herebefrogs/dataglove-as-numpad/images/1.Prototype for software.jpg

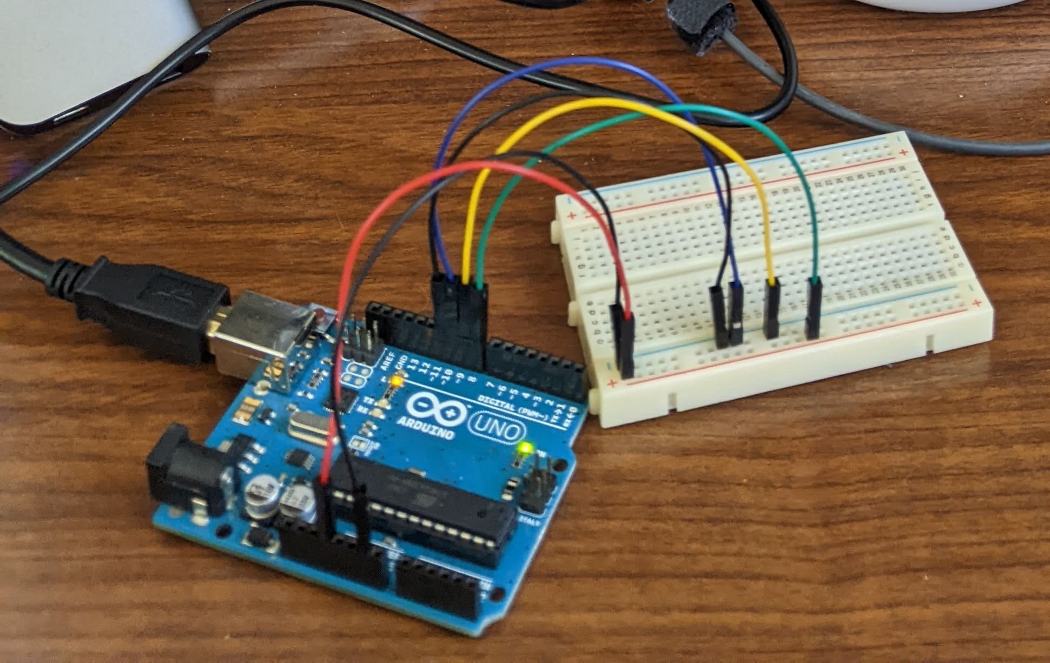
images/1.Prototype for software.jpg
