herebefrogs/dataglove-as-numpad/images/2.Software Command Line Interface.jpg

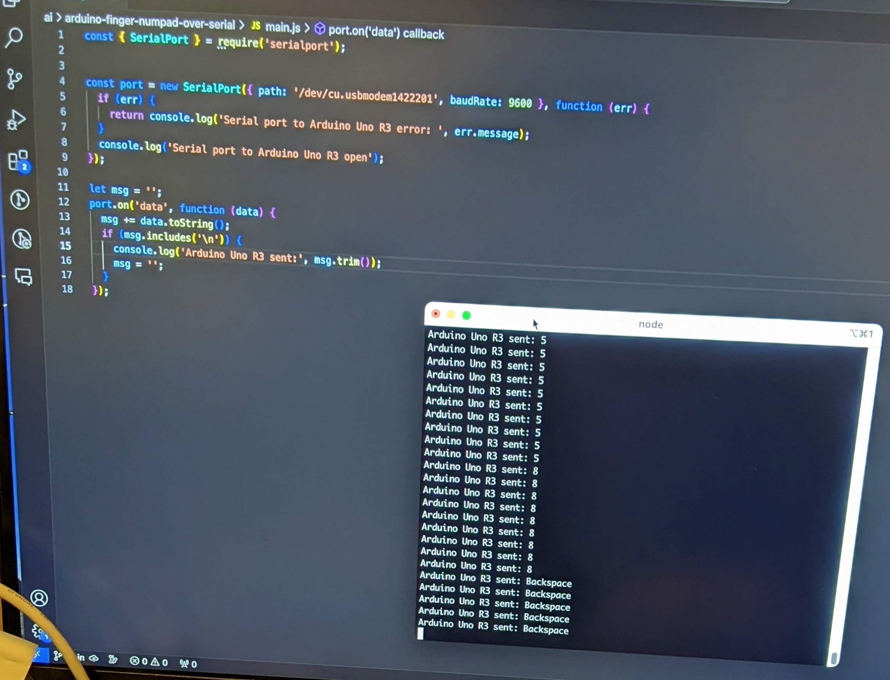
images/2.Software Command Line Interface.jpg
