herebefrogs/dataglove-as-numpad/images/3.Software Web Page.jpg

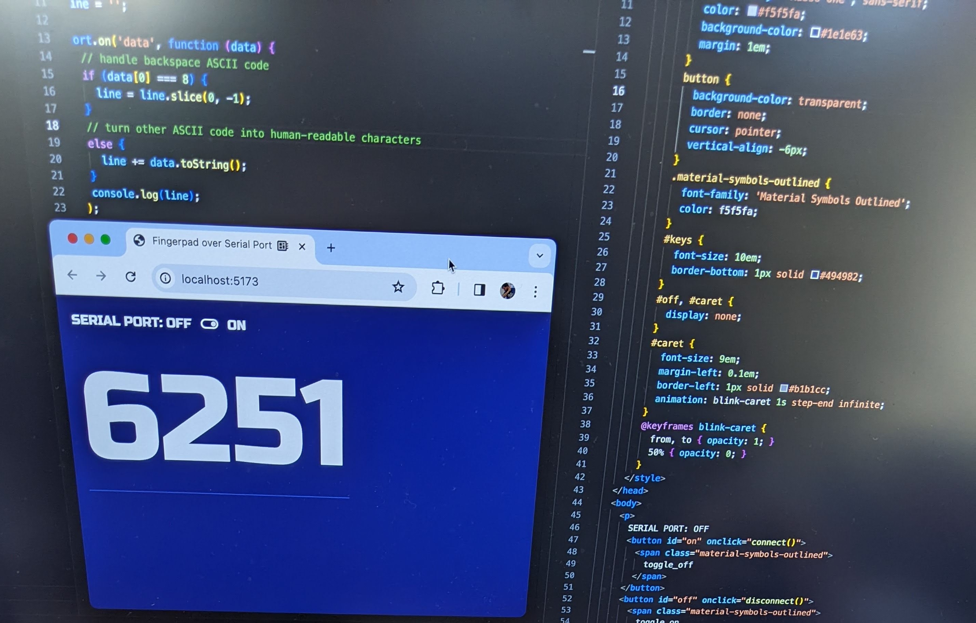
images/3.Software Web Page.jpg
