herebefrogs/dataglove-as-numpad/images/4.Paper prototype for hardware.jpg

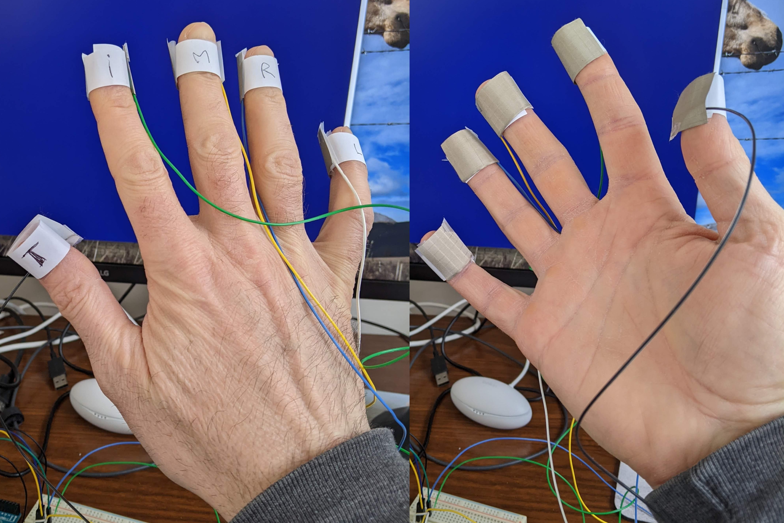
images/4.Paper prototype for hardware.jpg
