herebefrogs/dataglove-as-numpad/images/5.Hardware glove step 1.jpg

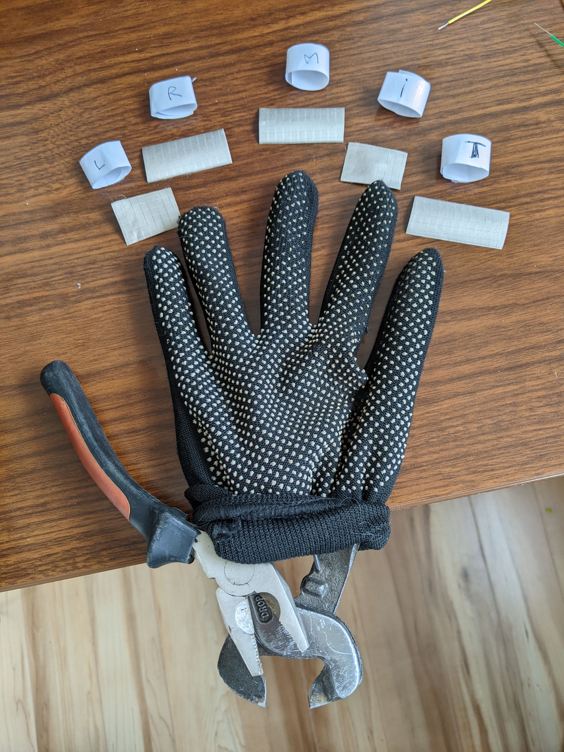
images/5.Hardware glove step 1.jpg
