herebefrogs/dataglove-as-numpad/images/6.Hardware glove step 2.jpg

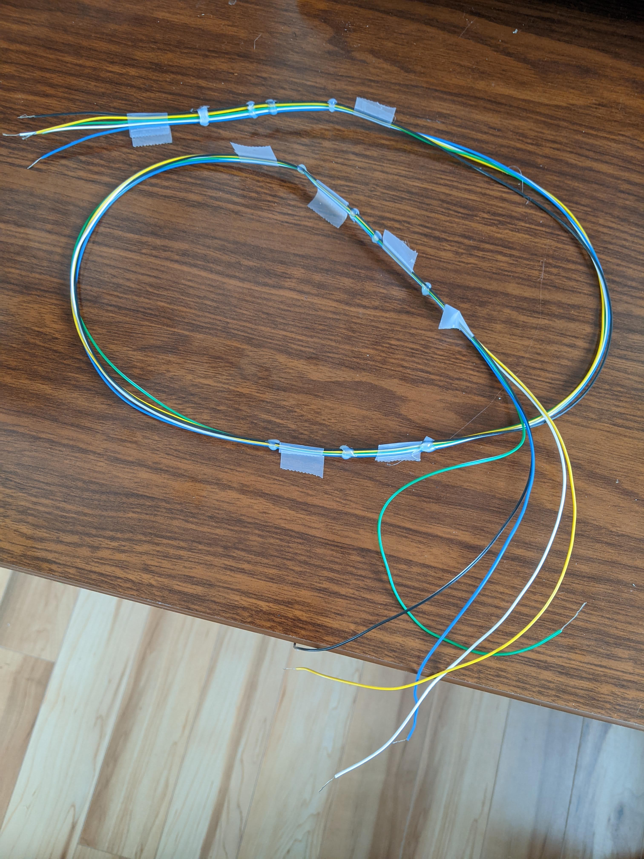
images/6.Hardware glove step 2.jpg
