herebefrogs/dataglove-as-numpad/images/6.Hardware glove step 3.jpg

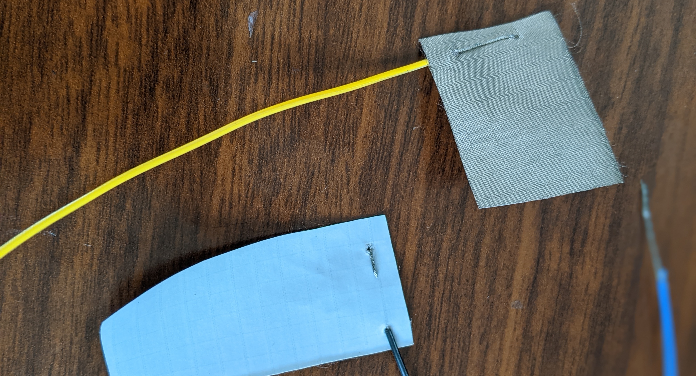
images/6.Hardware glove step 3.jpg
