herebefrogs/dataglove-as-numpad/images/6.Hardware glove step 4 FAIL.jpg

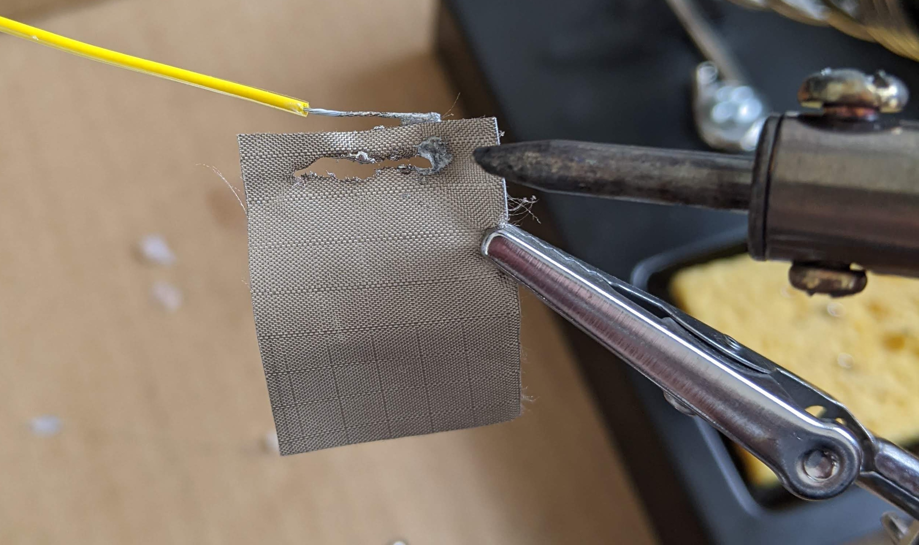
images/6.Hardware glove step 4 FAIL.jpg
