herebefrogs/dataglove-as-numpad/images/6.Hardware glove step 4.jpg

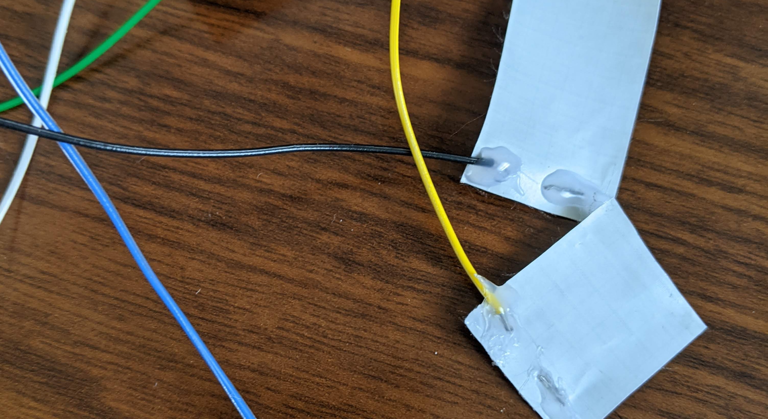
images/6.Hardware glove step 4.jpg
