herebefrogs/dataglove-as-numpad/images/6.Hardware glove step 5.jpg

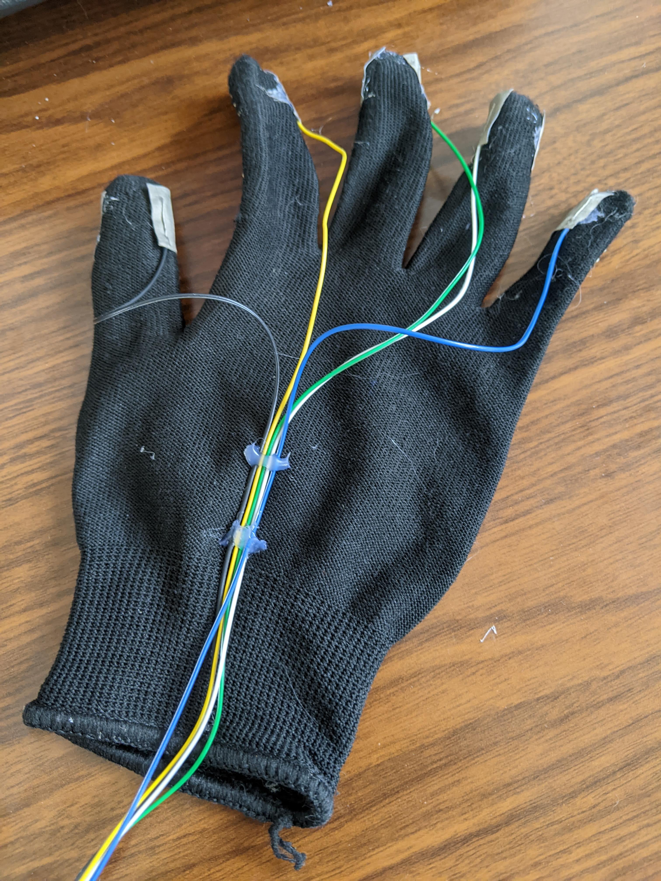
images/6.Hardware glove step 5.jpg
