herebefrogs/dataglove-as-numpad/images/6.Hardware glove step 6.jpg

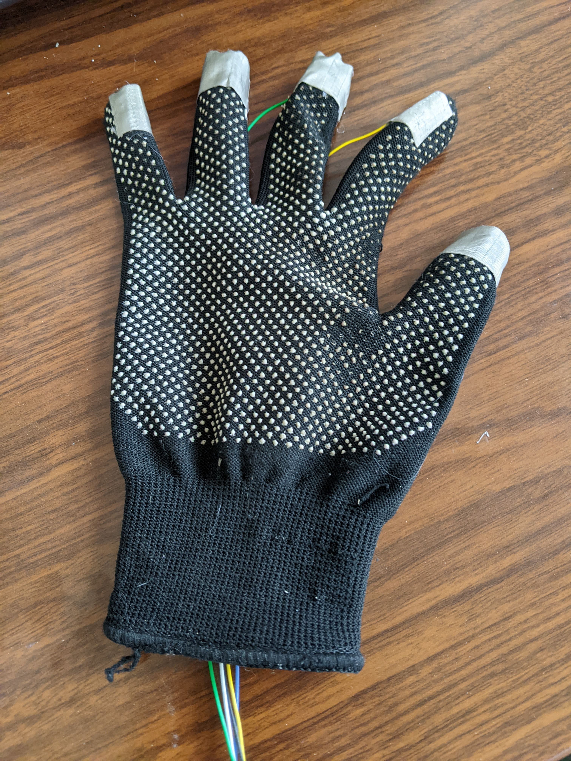
images/6.Hardware glove step 6.jpg
