herebefrogs/dataglove-as-numpad/(commit log)

2024-02-07 Sketch, CLI and Web version working for individual fingers
    Combination of fingers must be debounced to avoid inputing
    individual fingers during the (de)assembling of the combinations.
    [sketch-fingernumpad.ino]
2024-02-07 Fix multi-finger inputs registering as series of single inputs
    Added a debounce before sending the key over Serial.
    e.g. 6 isn't 46 anymore.
    [sketch-fingernumpad.ino]
2024-02-14 Add data glove build instructions, wiring and reference pictures/videos
